IljaRusch/Elektromechanischer-Greifer-mit-Force-Feedback-Funktion/README.md

# Elektromechanischer-Greifer-mit-Force-Feedback-Funktion
https://youtu.be/dZC01sUtcBQ
